johnathan-convertino-afrl/open1553/hardware/pmod/pmod_SCHEMATIC.pdf

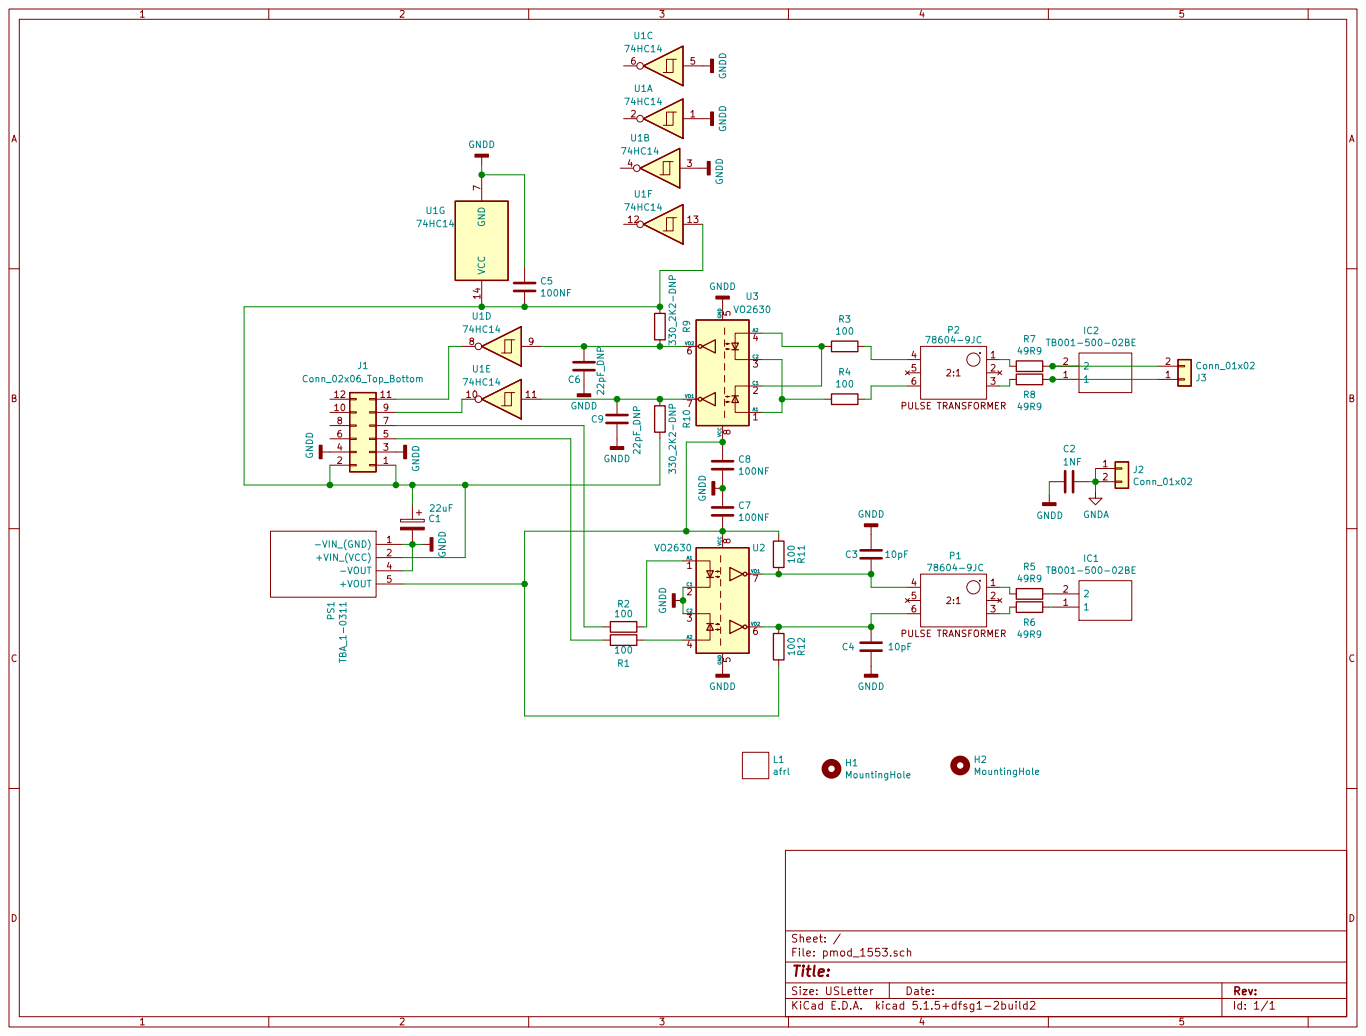
[picture p3: page 1]

File: pmod_1553.sch Sheet: / VCC 14 GND
