johnathan-convertino-afrl/open1553/hardware/pmod/kicad/pmod_1553.kicad_pcb

## KiCad design hardware/pmod/kicad/pmod_1553.kicad_pcb (2022-01-05)

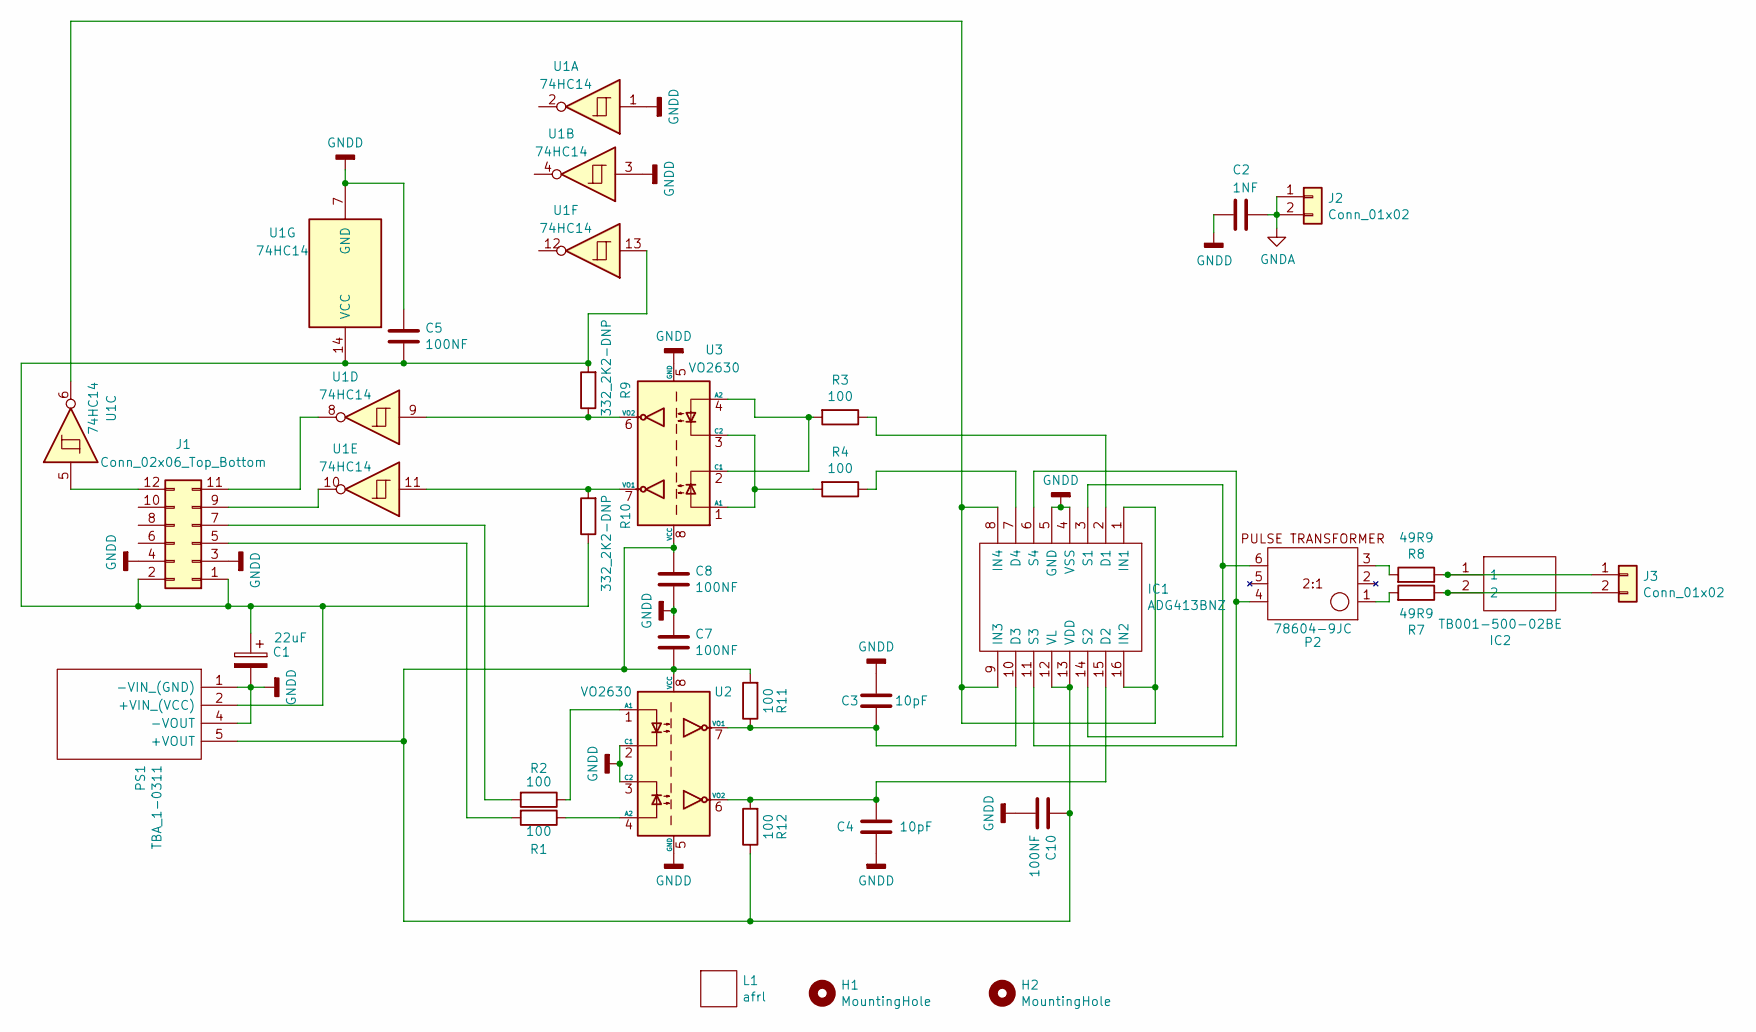
[picture p4: schematic pmod_1553.sch]

Parts:
C1: 22uF; CP_Radial_D5.0mm_P2.50mm
C2: 1NF; C_Disc_D4.7mm_W2.5mm_P5.00mm
C3, C4: 10pF; C_Disc_D4.7mm_W2.5mm_P5.00mm
C5, C7, C8, C10: 100NF; C_Disc_D4.7mm_W2.5mm_P5.00mm
H1, H2: MountingHole; MountingHole_2.2mm_M2_DIN965
IC1: ADG413BNZ; DIP-16_W7.62mm_LongPads; Manufacturer_Part_Number ADG413BNZ
IC2: TB001-500-02BE; TB00150002BE; Manufacturer_Part_Number TB001-500-02BE; Mouser Part Number 490-TB001-500-02BE
J1: Conn_02x06_Top_Bottom; PinHeader_2x06_P2.54mm_Horizontal
J2: Conn_01x02; Molex_KK-254_AE-6410-02A_1x02_P2.54mm_Vertical
J3: Conn_01x02; PinHeader_1x02_P2.54mm_Vertical
L1: afrl
P2: 78604-9JC
PS1: TBA_1-0311; TBA10311; Manufacturer_Part_Number TBA 1-0311; Mouser Part Number 495-TBA1-0311
R1, R2, R3, R4, R11, R12: 100; R_Axial_DIN0207_L6.3mm_D2.5mm_P7.62mm_Horizontal
R7, R8: 49R9; R_Axial_DIN0207_L6.3mm_D2.5mm_P7.62mm_Horizontal
R9, R10: 332_2K2-DNP; R_Axial_DIN0207_L6.3mm_D2.5mm_P7.62mm_Horizontal
U1: 74HC14; DIP-14_W7.62mm_LongPads
U2, U3: VO2630; DIP-8_W7.62mm

Connections:
GNDA: C2.1, J2.1, J2.2
GNDD: C1.2, C2.2, C3.1, C4.2, C5.1, C7.1, C8.2, C10.2, IC1.4 (VSS), IC1.5 (GND), J1.3, J1.4, PS1.1 (-VIN_(GND)), PS1.4 (-VOUT), U1.1, U1.3, U1.7 (GND), U2.2 (C1), U2.3 (C2), U2.5 (GND), U3.5 (GND)
unnamed: C1.1, C5.2, J1.1, J1.2, PS1.2 (+VIN_(VCC)), R9.2, R10.1, U1.13, U1.14 (VCC)
unnamed: C3.2, IC1.10 (D3), R11.1, U2.7 (VO1)
unnamed: C4.1, IC1.15 (D2), R12.2, U2.6 (VO2)
unnamed: C7.2, C8.1, C10.1, IC1.12 (VL), IC1.13 (VDD), PS1.5 (+VOUT), R11.2, R12.1, U2.8 (VCC), U3.8 (VCC)
unnamed: IC1.1 (IN1), IC1.8 (IN4), IC1.9 (IN3), IC1.16 (IN2), U1.6
unnamed: IC1.2 (D1), R3.1
unnamed: IC1.7 (D4), R4.1
unnamed: IC1.6 (S4), IC1.11 (S3), P2.4
unnamed: IC1.3 (S1), IC1.14 (S2), P2.6
unnamed: IC2.1, J3.1, R8.1
unnamed: IC2.2, J3.2, R7.1
unnamed: J1.5, R1.2
unnamed: J1.7, R2.2
unnamed: J1.9, U1.10
unnamed: J1.11, U1.8
unnamed: J1.12, U1.5
unnamed: P2.1, R7.2
unnamed: P2.3, R8.2
unnamed: R1.1, U2.4 (A2)
unnamed: R2.1, U2.1 (A1)
unnamed: R3.2, U3.2 (C1), U3.4 (A2)
unnamed: R4.2, U3.1 (A1), U3.3 (C2)
unnamed: R9.1, U1.9, U3.6 (VO2)
unnamed: R10.2, U1.11, U3.7 (VO1)

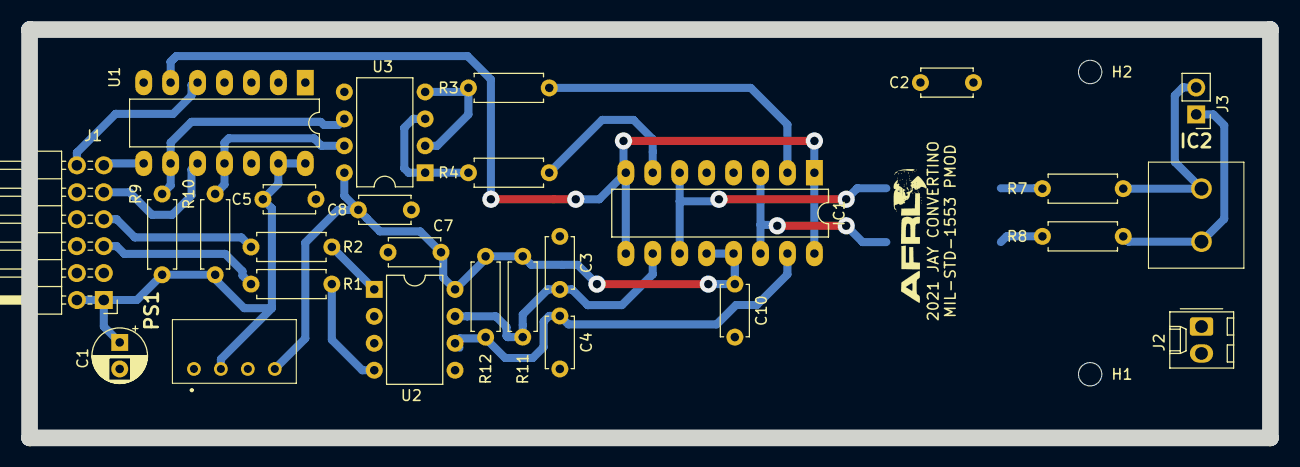
[picture p5: board pmod_1553.kicad_pcb from above]

Board: 2 copper layers, 117.0 x 38.5 mm, 31 parts (1 on the bottom side), 26 nets.
