johnathan-convertino-afrl/open1553/HDL/projects/common/nexys-a7-100t/nexys-a7-100t_system_constr.xdc

## constraints

## 100 Mhz clock from board
set_property -dict {PACKAGE_PIN E3 IOSTANDARD LVCMOS33} [get_ports clk_100mhz]
create_clock -period 10.000 -name board_clk_100mhz -waveform {0.000 5.000} -add [get_ports clk_100mhz]

## reset
set_property -dict {PACKAGE_PIN C12 IOSTANDARD LVCMOS33} [get_ports resetn]

## leds
set_property -dict { PACKAGE_PIN H17   IOSTANDARD LVCMOS33 } [get_ports { leds[0] }]
set_property -dict { PACKAGE_PIN K15   IOSTANDARD LVCMOS33 } [get_ports { leds[1] }]
set_property -dict { PACKAGE_PIN J13   IOSTANDARD LVCMOS33 } [get_ports { leds[2] }]
set_property -dict { PACKAGE_PIN N14   IOSTANDARD LVCMOS33 } [get_ports { leds[3] }]
set_property -dict { PACKAGE_PIN R18   IOSTANDARD LVCMOS33 } [get_ports { leds[4] }]
set_property -dict { PACKAGE_PIN V17   IOSTANDARD LVCMOS33 } [get_ports { leds[5] }]
set_property -dict { PACKAGE_PIN U17   IOSTANDARD LVCMOS33 } [get_ports { leds[6] }]
set_property -dict { PACKAGE_PIN U16   IOSTANDARD LVCMOS33 } [get_ports { leds[7] }]
set_property -dict { PACKAGE_PIN V16   IOSTANDARD LVCMOS33 } [get_ports { leds[8] }]
set_property -dict { PACKAGE_PIN T15   IOSTANDARD LVCMOS33 } [get_ports { leds[9] }]
set_property -dict { PACKAGE_PIN U14   IOSTANDARD LVCMOS33 } [get_ports { leds[10] }]
set_property -dict { PACKAGE_PIN T16   IOSTANDARD LVCMOS33 } [get_ports { leds[11] }]
set_property -dict { PACKAGE_PIN V15   IOSTANDARD LVCMOS33 } [get_ports { leds[12] }]
set_property -dict { PACKAGE_PIN V14   IOSTANDARD LVCMOS33 } [get_ports { leds[13] }]
set_property -dict { PACKAGE_PIN V12   IOSTANDARD LVCMOS33 } [get_ports { leds[14] }]
set_property -dict { PACKAGE_PIN V11   IOSTANDARD LVCMOS33 } [get_ports { leds[15] }]

## RGB led 0
set_property -dict {PACKAGE_PIN R12 IOSTANDARD LVCMOS33} [get_ports {rgb_led0[0]}]
set_property -dict {PACKAGE_PIN M16 IOSTANDARD LVCMOS33} [get_ports {rgb_led0[1]}]
set_property -dict {PACKAGE_PIN N15 IOSTANDARD LVCMOS33} [get_ports {rgb_led0[2]}]

## RGB led 1
set_property -dict {PACKAGE_PIN G14 IOSTANDARD LVCMOS33} [get_ports {rgb_led1[0]}]
set_property -dict {PACKAGE_PIN R11 IOSTANDARD LVCMOS33} [get_ports {rgb_led1[1]}]
set_property -dict {PACKAGE_PIN N16 IOSTANDARD LVCMOS33} [get_ports {rgb_led1[2]}]

## push_buttons
set_property -dict {PACKAGE_PIN N17 IOSTANDARD LVCMOS33} [get_ports {push_buttons[0]}]
set_property -dict {PACKAGE_PIN M18 IOSTANDARD LVCMOS33} [get_ports {push_buttons[1]}]
set_property -dict {PACKAGE_PIN P17 IOSTANDARD LVCMOS33} [get_ports {push_buttons[2]}]
set_property -dict {PACKAGE_PIN M17 IOSTANDARD LVCMOS33} [get_ports {push_buttons[3]}]
set_property -dict {PACKAGE_PIN P18 IOSTANDARD LVCMOS33} [get_ports {push_buttons[4]}]

## slide_switches
#set_property -dict { PACKAGE_PIN J15   IOSTANDARD LVCMOS33 } [get_ports { slide_switches[0] }]
#set_property -dict { PACKAGE_PIN L16   IOSTANDARD LVCMOS33 } [get_ports { slide_switches[1] }]
#set_property -dict { PACKAGE_PIN M13   IOSTANDARD LVCMOS33 } [get_ports { slide_switches[2] }]
#set_property -dict { PACKAGE_PIN R15   IOSTANDARD LVCMOS33 } [get_ports { slide_switches[3] }]
#set_property -dict { PACKAGE_PIN R17   IOSTANDARD LVCMOS33 } [get_ports { slide_switches[4] }]
#set_property -dict { PACKAGE_PIN T18   IOSTANDARD LVCMOS33 } [get_ports { slide_switches[5] }]
#set_property -dict { PACKAGE_PIN U18   IOSTANDARD LVCMOS33 } [get_ports { slide_switches[6] }]
#set_property -dict { PACKAGE_PIN R13   IOSTANDARD LVCMOS33 } [get_ports { slide_switches[7] }]
#set_property -dict { PACKAGE_PIN T8    IOSTANDARD LVCMOS18 } [get_ports { slide_switches[8] }]
#set_property -dict { PACKAGE_PIN U8    IOSTANDARD LVCMOS18 } [get_ports { slide_switches[9] }]
#set_property -dict { PACKAGE_PIN R16   IOSTANDARD LVCMOS33 } [get_ports { slide_switches[10] }]
#set_property -dict { PACKAGE_PIN T13   IOSTANDARD LVCMOS33 } [get_ports { slide_switches[11] }]
#set_property -dict { PACKAGE_PIN H6    IOSTANDARD LVCMOS33 } [get_ports { slide_switches[12] }]
#set_property -dict { PACKAGE_PIN U12   IOSTANDARD LVCMOS33 } [get_ports { slide_switches[13] }]
#set_property -dict { PACKAGE_PIN U11   IOSTANDARD LVCMOS33 } [get_ports { slide_switches[14] }]
#set_property -dict { PACKAGE_PIN V10   IOSTANDARD LVCMOS33 } [get_ports { slide_switches[15] }]

## uart
set_property PACKAGE_PIN C4 [get_ports ftdi_tx]
set_property IOSTANDARD LVCMOS33 [get_ports ftdi_tx]
set_property SLEW FAST [get_ports ftdi_tx]
set_property DRIVE 4 [get_ports ftdi_tx]
set_property -dict {PACKAGE_PIN D4 IOSTANDARD LVCMOS33} [get_ports ftdi_rx]
set_property -dict {PACKAGE_PIN D3 IOSTANDARD LVCMOS33} [get_ports ftdi_cts]
set_property -dict {PACKAGE_PIN E5 IOSTANDARD LVCMOS33} [get_ports ftdi_rts]

##Pmod Headers
##Pmod Header pmod_ja
set_property -dict { PACKAGE_PIN C17   IOSTANDARD LVCMOS33 } [get_ports { pmod_ja[0] }]
set_property -dict { PACKAGE_PIN D18   IOSTANDARD LVCMOS33 } [get_ports { pmod_ja[1] }]
set_property -dict { PACKAGE_PIN E18   IOSTANDARD LVCMOS33 } [get_ports { pmod_ja[2] }]
set_property -dict { PACKAGE_PIN G17   IOSTANDARD LVCMOS33 } [get_ports { pmod_ja[3] }]
set_property -dict { PACKAGE_PIN D17   IOSTANDARD LVCMOS33 } [get_ports { pmod_ja[4] }]
set_property -dict { PACKAGE_PIN E17   IOSTANDARD LVCMOS33 } [get_ports { pmod_ja[5] }]
set_property -dict { PACKAGE_PIN F18   IOSTANDARD LVCMOS33 } [get_ports { pmod_ja[6] }]
set_property -dict { PACKAGE_PIN G18   IOSTANDARD LVCMOS33 } [get_ports { pmod_ja[7] }]

##Pmod Header pmod_jb
set_property -dict { PACKAGE_PIN D14   IOSTANDARD LVCMOS33 } [get_ports { pmod_jb[0] }]
set_property -dict { PACKAGE_PIN F16   IOSTANDARD LVCMOS33 } [get_ports { pmod_jb[1] }]
set_property -dict { PACKAGE_PIN G16   IOSTANDARD LVCMOS33 } [get_ports { pmod_jb[2] }]
set_property -dict { PACKAGE_PIN H14   IOSTANDARD LVCMOS33 } [get_ports { pmod_jb[3] }]
set_property -dict { PACKAGE_PIN E16   IOSTANDARD LVCMOS33 } [get_ports { pmod_jb[4] }]
set_property -dict { PACKAGE_PIN F13   IOSTANDARD LVCMOS33 } [get_ports { pmod_jb[5] }]
set_property -dict { PACKAGE_PIN G13   IOSTANDARD LVCMOS33 } [get_ports { pmod_jb[6] }]
set_property -dict { PACKAGE_PIN H16   IOSTANDARD LVCMOS33 } [get_ports { pmod_jb[7] }]

##Pmod Header pmod_jc
set_property -dict { PACKAGE_PIN K1    IOSTANDARD LVCMOS33 } [get_ports { pmod_jc[0] }]
set_property -dict { PACKAGE_PIN F6    IOSTANDARD LVCMOS33 } [get_ports { pmod_jc[1] }]
set_property -dict { PACKAGE_PIN J2    IOSTANDARD LVCMOS33 } [get_ports { pmod_jc[2] }]
set_property -dict { PACKAGE_PIN G6    IOSTANDARD LVCMOS33 } [get_ports { pmod_jc[3] }]
set_property -dict { PACKAGE_PIN E7    IOSTANDARD LVCMOS33 } [get_ports { pmod_jc[4] }]
set_property -dict { PACKAGE_PIN J3    IOSTANDARD LVCMOS33 } [get_ports { pmod_jc[5] }]
set_property -dict { PACKAGE_PIN J4    IOSTANDARD LVCMOS33 } [get_ports { pmod_jc[6] }]
set_property -dict { PACKAGE_PIN E6    IOSTANDARD LVCMOS33 } [get_ports { pmod_jc[7] }]

##Pmod Header pmod_jd
set_property -dict { PACKAGE_PIN H4    IOSTANDARD LVCMOS33 } [get_ports { pmod_jd[0] }]
set_property -dict { PACKAGE_PIN H1    IOSTANDARD LVCMOS33 } [get_ports { pmod_jd[1] }]
set_property -dict { PACKAGE_PIN G1    IOSTANDARD LVCMOS33 } [get_ports { pmod_jd[2] }]
set_property -dict { PACKAGE_PIN G3    IOSTANDARD LVCMOS33 } [get_ports { pmod_jd[3] }]
set_property -dict { PACKAGE_PIN H2    IOSTANDARD LVCMOS33 } [get_ports { pmod_jd[4] }]
set_property -dict { PACKAGE_PIN G4    IOSTANDARD LVCMOS33 } [get_ports { pmod_jd[5] }]
set_property -dict { PACKAGE_PIN G2    IOSTANDARD LVCMOS33 } [get_ports { pmod_jd[6] }]
set_property -dict { PACKAGE_PIN F3    IOSTANDARD LVCMOS33 } [get_ports { pmod_jd[7] }]

##Pmod Header JXADC
#set_property -dict { PACKAGE_PIN A14   IOSTANDARD LVCMOS33 } [get_ports { XA_N[1] }]
#set_property -dict { PACKAGE_PIN A13   IOSTANDARD LVCMOS33 } [get_ports { XA_P[1] }]
#set_property -dict { PACKAGE_PIN A16   IOSTANDARD LVCMOS33 } [get_ports { XA_N[2] }]
#set_property -dict { PACKAGE_PIN A15   IOSTANDARD LVCMOS33 } [get_ports { XA_P[2] }]
#set_property -dict { PACKAGE_PIN B17   IOSTANDARD LVCMOS33 } [get_ports { XA_N[3] }]
#set_property -dict { PACKAGE_PIN B16   IOSTANDARD LVCMOS33 } [get_ports { XA_P[3] }]
#set_property -dict { PACKAGE_PIN A18   IOSTANDARD LVCMOS33 } [get_ports { XA_N[4] }]
#set_property -dict { PACKAGE_PIN B18   IOSTANDARD LVCMOS33 } [get_ports { XA_P[4] }]
