johnathan-convertino-afrl/open1553/HDL/projects/common/zed/zed_system_constr.xdc

# constraints
# hdmi

set_property -dict {PACKAGE_PIN W18 IOSTANDARD LVCMOS33} [get_ports hdmi_out_clk]
set_property -dict {PACKAGE_PIN W17 IOSTANDARD LVCMOS33 IOB TRUE} [get_ports hdmi_vsync]
set_property -dict {PACKAGE_PIN V17 IOSTANDARD LVCMOS33 IOB TRUE} [get_ports hdmi_hsync]
set_property -dict {PACKAGE_PIN U16 IOSTANDARD LVCMOS33 IOB TRUE} [get_ports hdmi_data_e]
set_property -dict {PACKAGE_PIN Y13 IOSTANDARD LVCMOS33 IOB TRUE} [get_ports {hdmi_data[0]}]
set_property -dict {PACKAGE_PIN AA13 IOSTANDARD LVCMOS33 IOB TRUE} [get_ports {hdmi_data[1]}]
set_property -dict {PACKAGE_PIN AA14 IOSTANDARD LVCMOS33 IOB TRUE} [get_ports {hdmi_data[2]}]
set_property -dict {PACKAGE_PIN Y14 IOSTANDARD LVCMOS33 IOB TRUE} [get_ports {hdmi_data[3]}]
set_property -dict {PACKAGE_PIN AB15 IOSTANDARD LVCMOS33 IOB TRUE} [get_ports {hdmi_data[4]}]
set_property -dict {PACKAGE_PIN AB16 IOSTANDARD LVCMOS33 IOB TRUE} [get_ports {hdmi_data[5]}]
set_property -dict {PACKAGE_PIN AA16 IOSTANDARD LVCMOS33 IOB TRUE} [get_ports {hdmi_data[6]}]
set_property -dict {PACKAGE_PIN AB17 IOSTANDARD LVCMOS33 IOB TRUE} [get_ports {hdmi_data[7]}]
set_property -dict {PACKAGE_PIN AA17 IOSTANDARD LVCMOS33 IOB TRUE} [get_ports {hdmi_data[8]}]
set_property -dict {PACKAGE_PIN Y15 IOSTANDARD LVCMOS33 IOB TRUE} [get_ports {hdmi_data[9]}]
set_property -dict {PACKAGE_PIN W13 IOSTANDARD LVCMOS33 IOB TRUE} [get_ports {hdmi_data[10]}]
set_property -dict {PACKAGE_PIN W15 IOSTANDARD LVCMOS33 IOB TRUE} [get_ports {hdmi_data[11]}]
set_property -dict {PACKAGE_PIN V15 IOSTANDARD LVCMOS33 IOB TRUE} [get_ports {hdmi_data[12]}]
set_property -dict {PACKAGE_PIN U17 IOSTANDARD LVCMOS33 IOB TRUE} [get_ports {hdmi_data[13]}]
set_property -dict {PACKAGE_PIN V14 IOSTANDARD LVCMOS33 IOB TRUE} [get_ports {hdmi_data[14]}]
set_property -dict {PACKAGE_PIN V13 IOSTANDARD LVCMOS33 IOB TRUE} [get_ports {hdmi_data[15]}]

## spdif

set_property -dict {PACKAGE_PIN U15 IOSTANDARD LVCMOS33} [get_ports spdif]

## i2s

set_property -dict {PACKAGE_PIN AB2 IOSTANDARD LVCMOS33} [get_ports i2s_mclk]
set_property -dict {PACKAGE_PIN AA6 IOSTANDARD LVCMOS33} [get_ports i2s_bclk]
set_property -dict {PACKAGE_PIN Y6 IOSTANDARD LVCMOS33} [get_ports i2s_lrclk]
set_property -dict {PACKAGE_PIN Y8 IOSTANDARD LVCMOS33} [get_ports i2s_sdata_out]
set_property -dict {PACKAGE_PIN AA7 IOSTANDARD LVCMOS33} [get_ports i2s_sdata_in]

# iic

set_property -dict {PACKAGE_PIN R7 IOSTANDARD LVCMOS33} [get_ports iic_scl]
set_property -dict {PACKAGE_PIN U7 IOSTANDARD LVCMOS33} [get_ports iic_sda]
set_property PACKAGE_PIN AA18 [get_ports {iic_mux_scl[1]}]
set_property IOSTANDARD LVCMOS33 [get_ports {iic_mux_scl[1]}]
set_property PULLUP true [get_ports {iic_mux_scl[1]}]
set_property PACKAGE_PIN Y16 [get_ports {iic_mux_sda[1]}]
set_property IOSTANDARD LVCMOS33 [get_ports {iic_mux_sda[1]}]
set_property PULLUP true [get_ports {iic_mux_sda[1]}]
set_property PACKAGE_PIN AB4 [get_ports {iic_mux_scl[0]}]
set_property IOSTANDARD LVCMOS33 [get_ports {iic_mux_scl[0]}]
set_property PULLUP true [get_ports {iic_mux_scl[0]}]
set_property PACKAGE_PIN AB5 [get_ports {iic_mux_sda[0]}]
set_property IOSTANDARD LVCMOS33 [get_ports {iic_mux_sda[0]}]
set_property PULLUP true [get_ports {iic_mux_sda[0]}]

# otg

set_property -dict {PACKAGE_PIN L16 IOSTANDARD LVCMOS25} [get_ports otg_vbusoc]

# gpio (switches, leds and such)

set_property -dict {PACKAGE_PIN P16 IOSTANDARD LVCMOS25} [get_ports {gpio_bd[0]}]
set_property -dict {PACKAGE_PIN R16 IOSTANDARD LVCMOS25} [get_ports {gpio_bd[1]}]
set_property -dict {PACKAGE_PIN N15 IOSTANDARD LVCMOS25} [get_ports {gpio_bd[2]}]
set_property -dict {PACKAGE_PIN R18 IOSTANDARD LVCMOS25} [get_ports {gpio_bd[3]}]
set_property -dict {PACKAGE_PIN T18 IOSTANDARD LVCMOS25} [get_ports {gpio_bd[4]}]
set_property -dict {PACKAGE_PIN U10 IOSTANDARD LVCMOS33} [get_ports {gpio_bd[5]}]
set_property -dict {PACKAGE_PIN U9 IOSTANDARD LVCMOS33} [get_ports {gpio_bd[6]}]
set_property -dict {PACKAGE_PIN AB12 IOSTANDARD LVCMOS33} [get_ports {gpio_bd[7]}]
set_property -dict {PACKAGE_PIN AA12 IOSTANDARD LVCMOS33} [get_ports {gpio_bd[8]}]
set_property -dict {PACKAGE_PIN U11 IOSTANDARD LVCMOS33} [get_ports {gpio_bd[9]}]
set_property -dict {PACKAGE_PIN U12 IOSTANDARD LVCMOS33} [get_ports {gpio_bd[10]}]

set_property -dict {PACKAGE_PIN F22 IOSTANDARD LVCMOS25} [get_ports {gpio_bd[11]}]
set_property -dict {PACKAGE_PIN G22 IOSTANDARD LVCMOS25} [get_ports {gpio_bd[12]}]
set_property -dict {PACKAGE_PIN H22 IOSTANDARD LVCMOS25} [get_ports {gpio_bd[13]}]
set_property -dict {PACKAGE_PIN F21 IOSTANDARD LVCMOS25} [get_ports {gpio_bd[14]}]
set_property -dict {PACKAGE_PIN H19 IOSTANDARD LVCMOS25} [get_ports {gpio_bd[15]}]
set_property -dict {PACKAGE_PIN H18 IOSTANDARD LVCMOS25} [get_ports {gpio_bd[16]}]
set_property -dict {PACKAGE_PIN H17 IOSTANDARD LVCMOS25} [get_ports {gpio_bd[17]}]
set_property -dict {PACKAGE_PIN M15 IOSTANDARD LVCMOS25} [get_ports {gpio_bd[18]}]

set_property -dict {PACKAGE_PIN T22 IOSTANDARD LVCMOS33} [get_ports {gpio_bd[19]}]
set_property -dict {PACKAGE_PIN T21 IOSTANDARD LVCMOS33} [get_ports {gpio_bd[20]}]
set_property -dict {PACKAGE_PIN U22 IOSTANDARD LVCMOS33} [get_ports {gpio_bd[21]}]
set_property -dict {PACKAGE_PIN U21 IOSTANDARD LVCMOS33} [get_ports {gpio_bd[22]}]
set_property -dict {PACKAGE_PIN V22 IOSTANDARD LVCMOS33} [get_ports {gpio_bd[23]}]
set_property -dict {PACKAGE_PIN W22 IOSTANDARD LVCMOS33} [get_ports {gpio_bd[24]}]
set_property -dict {PACKAGE_PIN U19 IOSTANDARD LVCMOS33} [get_ports {gpio_bd[25]}]
set_property -dict {PACKAGE_PIN U14 IOSTANDARD LVCMOS33} [get_ports {gpio_bd[26]}]

set_property -dict {PACKAGE_PIN H15 IOSTANDARD LVCMOS25} [get_ports {gpio_bd[27]}]
set_property -dict {PACKAGE_PIN R15 IOSTANDARD LVCMOS25} [get_ports {gpio_bd[28]}]
set_property -dict {PACKAGE_PIN K15 IOSTANDARD LVCMOS25} [get_ports {gpio_bd[29]}]
set_property -dict {PACKAGE_PIN J15 IOSTANDARD LVCMOS25} [get_ports {gpio_bd[30]}]

set_property -dict {PACKAGE_PIN G17 IOSTANDARD LVCMOS25} [get_ports {gpio_bd[31]}]

# Define SPI clock
create_clock -period 40.000 -name spi0_clk [get_pins -hier */EMIOSPI0SCLKO]
create_clock -period 40.000 -name spi1_clk [get_pins -hier */EMIOSPI1SCLKO]
