johnathan-convertino-afrl/open1553/HDL/projects/uart_pmod1553/cmod-s7-25/system_constr.xdc

set_property BITSTREAM.GENERAL.COMPRESS TRUE [current_design]

## I/O delay constraints
create_clock -period 20.833 -name VIRTUAL_clk_out1_system_clk_wiz_48mhz_0 -waveform {0.000 10.417}
set_input_delay -clock [get_clocks VIRTUAL_clk_out1_system_clk_wiz_48mhz_0] -min -add_delay 1.000 [get_ports {push_buttons[*]}]
set_input_delay -clock [get_clocks VIRTUAL_clk_out1_system_clk_wiz_48mhz_0] -max -add_delay 8.000 [get_ports {push_buttons[*]}]
set_input_delay -clock [get_clocks VIRTUAL_clk_out1_system_clk_wiz_48mhz_0] -min -add_delay 0.500 [get_ports {pmod_ja[0]}]
set_input_delay -clock [get_clocks VIRTUAL_clk_out1_system_clk_wiz_48mhz_0] -min -add_delay 0.500 [get_ports {pmod_ja[1]}]
set_input_delay -clock [get_clocks VIRTUAL_clk_out1_system_clk_wiz_48mhz_0] -max -add_delay 4.000 [get_ports {pmod_ja[0]}]
set_input_delay -clock [get_clocks VIRTUAL_clk_out1_system_clk_wiz_48mhz_0] -max -add_delay 4.000 [get_ports {pmod_ja[1]}]
set_input_delay -clock [get_clocks VIRTUAL_clk_out1_system_clk_wiz_48mhz_0] -min -add_delay 0.020 [get_ports ftdi_tx]
set_input_delay -clock [get_clocks VIRTUAL_clk_out1_system_clk_wiz_48mhz_0] -max -add_delay 0.300 [get_ports ftdi_tx]
set_output_delay -clock [get_clocks VIRTUAL_clk_out1_system_clk_wiz_48mhz_0] -min -add_delay 0.500 [get_ports {pmod_ja[2]}]
set_output_delay -clock [get_clocks VIRTUAL_clk_out1_system_clk_wiz_48mhz_0] -min -add_delay 0.500 [get_ports {pmod_ja[3]}]
set_output_delay -clock [get_clocks VIRTUAL_clk_out1_system_clk_wiz_48mhz_0] -min -add_delay 0.500 [get_ports {pmod_ja[4]}]
set_output_delay -clock [get_clocks VIRTUAL_clk_out1_system_clk_wiz_48mhz_0] -max -add_delay 4.000 [get_ports {pmod_ja[2]}]
set_output_delay -clock [get_clocks VIRTUAL_clk_out1_system_clk_wiz_48mhz_0] -max -add_delay 4.000 [get_ports {pmod_ja[3]}]
set_output_delay -clock [get_clocks VIRTUAL_clk_out1_system_clk_wiz_48mhz_0] -max -add_delay 4.000 [get_ports {pmod_ja[4]}]
set_output_delay -clock [get_clocks VIRTUAL_clk_out1_system_clk_wiz_48mhz_0] -min -add_delay 0.050 [get_ports ftdi_rx]
set_output_delay -clock [get_clocks VIRTUAL_clk_out1_system_clk_wiz_48mhz_0] -max -add_delay 0.500 [get_ports ftdi_rx]

#set_property DRIVE 16  [get_ports {ftdi_tx}]
#set_property SLEW FAST [get_ports {ftdi_tx}]

set_property BITSTREAM.CONFIG.SPI_BUSWIDTH 4 [current_design]
