johnathan-convertino-afrl/open1553/(commit log)

2021-07-29 initial commit, needs better documentation and util_fifo/axis_xfifo test bench converted to verilog
    [pmod_1553.kicad_pcb, pmod_1553.sch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]
2021-08-01 updated schematic with output filter caps on recieve line. Added AFRL logo as a library so it won't get deleted.
    [pmod_1553.kicad_pcb, pmod_1553.sch]
2021-08-02 added testbench for fifos,they are barebones junk, but they are there and work with icarus.
    [pmod_1553.kicad_pcb, pmod_1553.sch]
2021-08-02 updated gerber files with design fixes. Readme got a few additions.
    [pmod_1553-B_Cu.gbr, pmod_1553-Edge_Cuts.gbr, pmod_1553-F_Cu.gbr, pmod_1553.drl]
2021-08-02 added alion fmc1553 board to project. tested build and intergration.
2021-08-05 added 1553 to fmc1553 core, need adc/dac interface connection. added arty mcs file.
    [pmod_1553.kicad_pcb, pmod_1553.sch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]
2021-08-09 added fmc1553 kernel mods and fixes for axis fifo build and device tree generation for fifo pmod1553
2021-08-09 added documents for linux build, dac switch added, and pcb has small updates.
    [pmod_1553.kicad_pcb, pmod_1553.sch]
2021-08-11 updated fmc1553 for encoder, it operates as it should. Buffer, DDS, and 1553 work. Buffer has priority if any data is sent to it.
2021-08-12 added zcu102 to pmod1553 project. Updated documents to reflect this change and added device tree to kernel.
2021-08-13 organized documents folder, added flow documents subfolder
2021-08-23 added debugs to help fix uart issues. Currently rx sync is off. Latest changes help, though it doesn't seem to be 100% fixed
    [arty-a7-35_system_constr.xdc, fifo1553_client.py, system_constr.xdc, system_top.v, uart1553_server.py]
2021-08-24 updates to uart to fix some more data issues. Added pipelines for RX/TX data that can be set to any length. Added pipelines to baud_gen cores to adjust uart_ena output as well. This allows for the da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
2021-08-24 updated projects with new specs for clock and uart core
2021-08-24 readded basic python examples for uart/fifo usage. These are NOT optimized and are terrible code, but do the job for a demo
2021-08-24 updated readme for uart
2021-08-24 schematic cleanup, add pdf for easy viewing on git
    [pmod_1553.sch]
2021-08-24 fixed 3D library paths
    [pmod_1553.kicad_pcb]
2021-08-25 added bill of materials
    [pmod_1553.sch]
2021-08-26 kicad url updates, they break removing the ? and after, but its clearer in seeing the make/model
    [pmod_1553.sch]
2021-08-26 bom updates
    [pmod_1553.sch]
2021-08-31 added quick start for uart strings
2021-11-29 added adg413 switch to pmod1553, added symbols and data sheets for the adg413 and mcp6d11.
    [pmod_1553.kicad_pcb, pmod_1553.sch]
2021-12-13 updated encoder with diff enable line. Added said line to needed cores and projects. Build untested.
    [pmod_1553.kicad_pcb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]
2021-12-28 added first version of C code to simulate a bus controller transfering a file to a remote terminal. This is not tested, besides it compiles (this will not work).
    [dox.cfg]
2021-12-29 non-working apps, complete rewrite creating threads in a seperate lib for mil-std-1553
2021-12-29 first version that compiles, applications need the threads setup. Makefiles updated, but still meh.
2022-01-05 removed c example, wasn't very good. Will revisit for version 3. This commit also contains various small fixes.
    [dox.cfg]
2022-01-05 last commit for version 2, updated readme
    [pmod_1553.kicad_pcb]
2022-04-18 changed uart to loop cts/rts (does nothing in the core... yet). Added nexys uart project. Build tested, not hardware approved
2022-04-19 fixed uart lines and changed the names so they make sense now
    [arty-a7-35_system_constr.xdc, cmod-s7-25_system_constr.xdc, nexys-a7-100t_system_constr.xdc, system_constr.xdc, system_top.v]
2022-08-17 fixed gitignore, and fixed cleanup for 2020.2.2 since it creates a gen folder
    [nexus-a7-100t_system_constr.xdc]
